diypinball/base-module-pcb/readme.txt

base-module-r1
==============
Size: Approx. 149mm x 99mm
Layers: 2
Silkscreen: White
Soldermask: Green
Thickness: 1.6mm
