diypinball/base-module-pcb/base-module-hardware-v2.kicad_pcb

## KiCad design base-module-hardware-v2.kicad_pcb (2016-09-09)

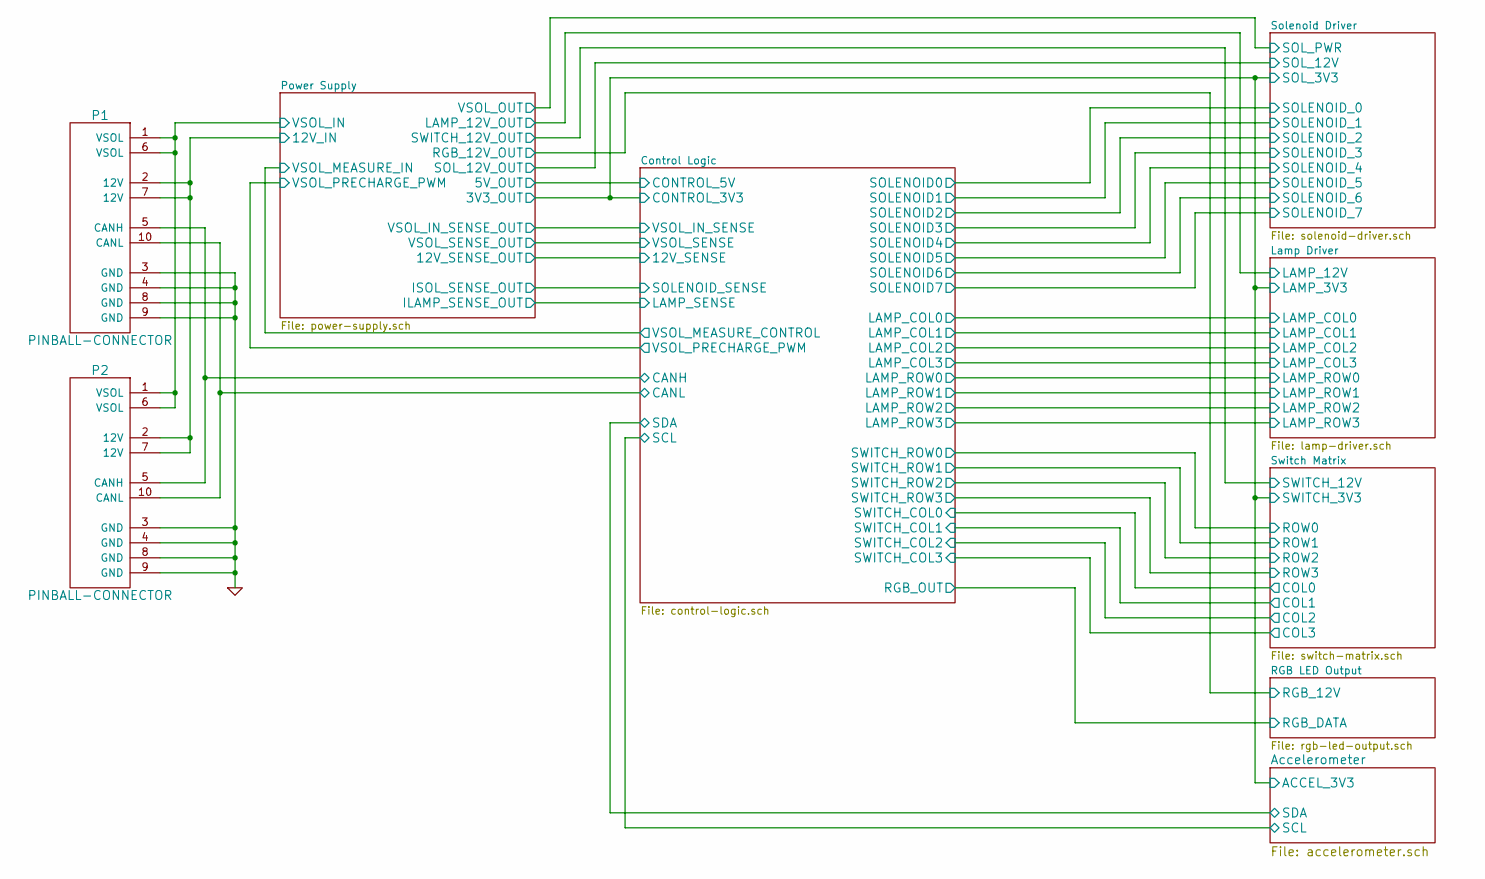
[picture p8: schematic base-module-hardware-v2.sch, DIYPinball Base Board]

Parts:
P1, P2: PINBALL-CONNECTOR; PINBALL-CONNECTOR-V

Connections:
/Control Logic/CANH: P1.5 (CANH), P2.5 (CANH); also elsewhere on the board
/Control Logic/CANL: P1.10 (CANL), P2.10 (CANL); also elsewhere on the board
/Power Supply/12V_IN: P1.2 (12V), P1.7 (12V), P2.2 (12V), P2.7 (12V); also elsewhere on the board
/Power Supply/VSOL_IN: P1.1 (VSOL), P1.6 (VSOL), P2.1 (VSOL), P2.6 (VSOL); also elsewhere on the board

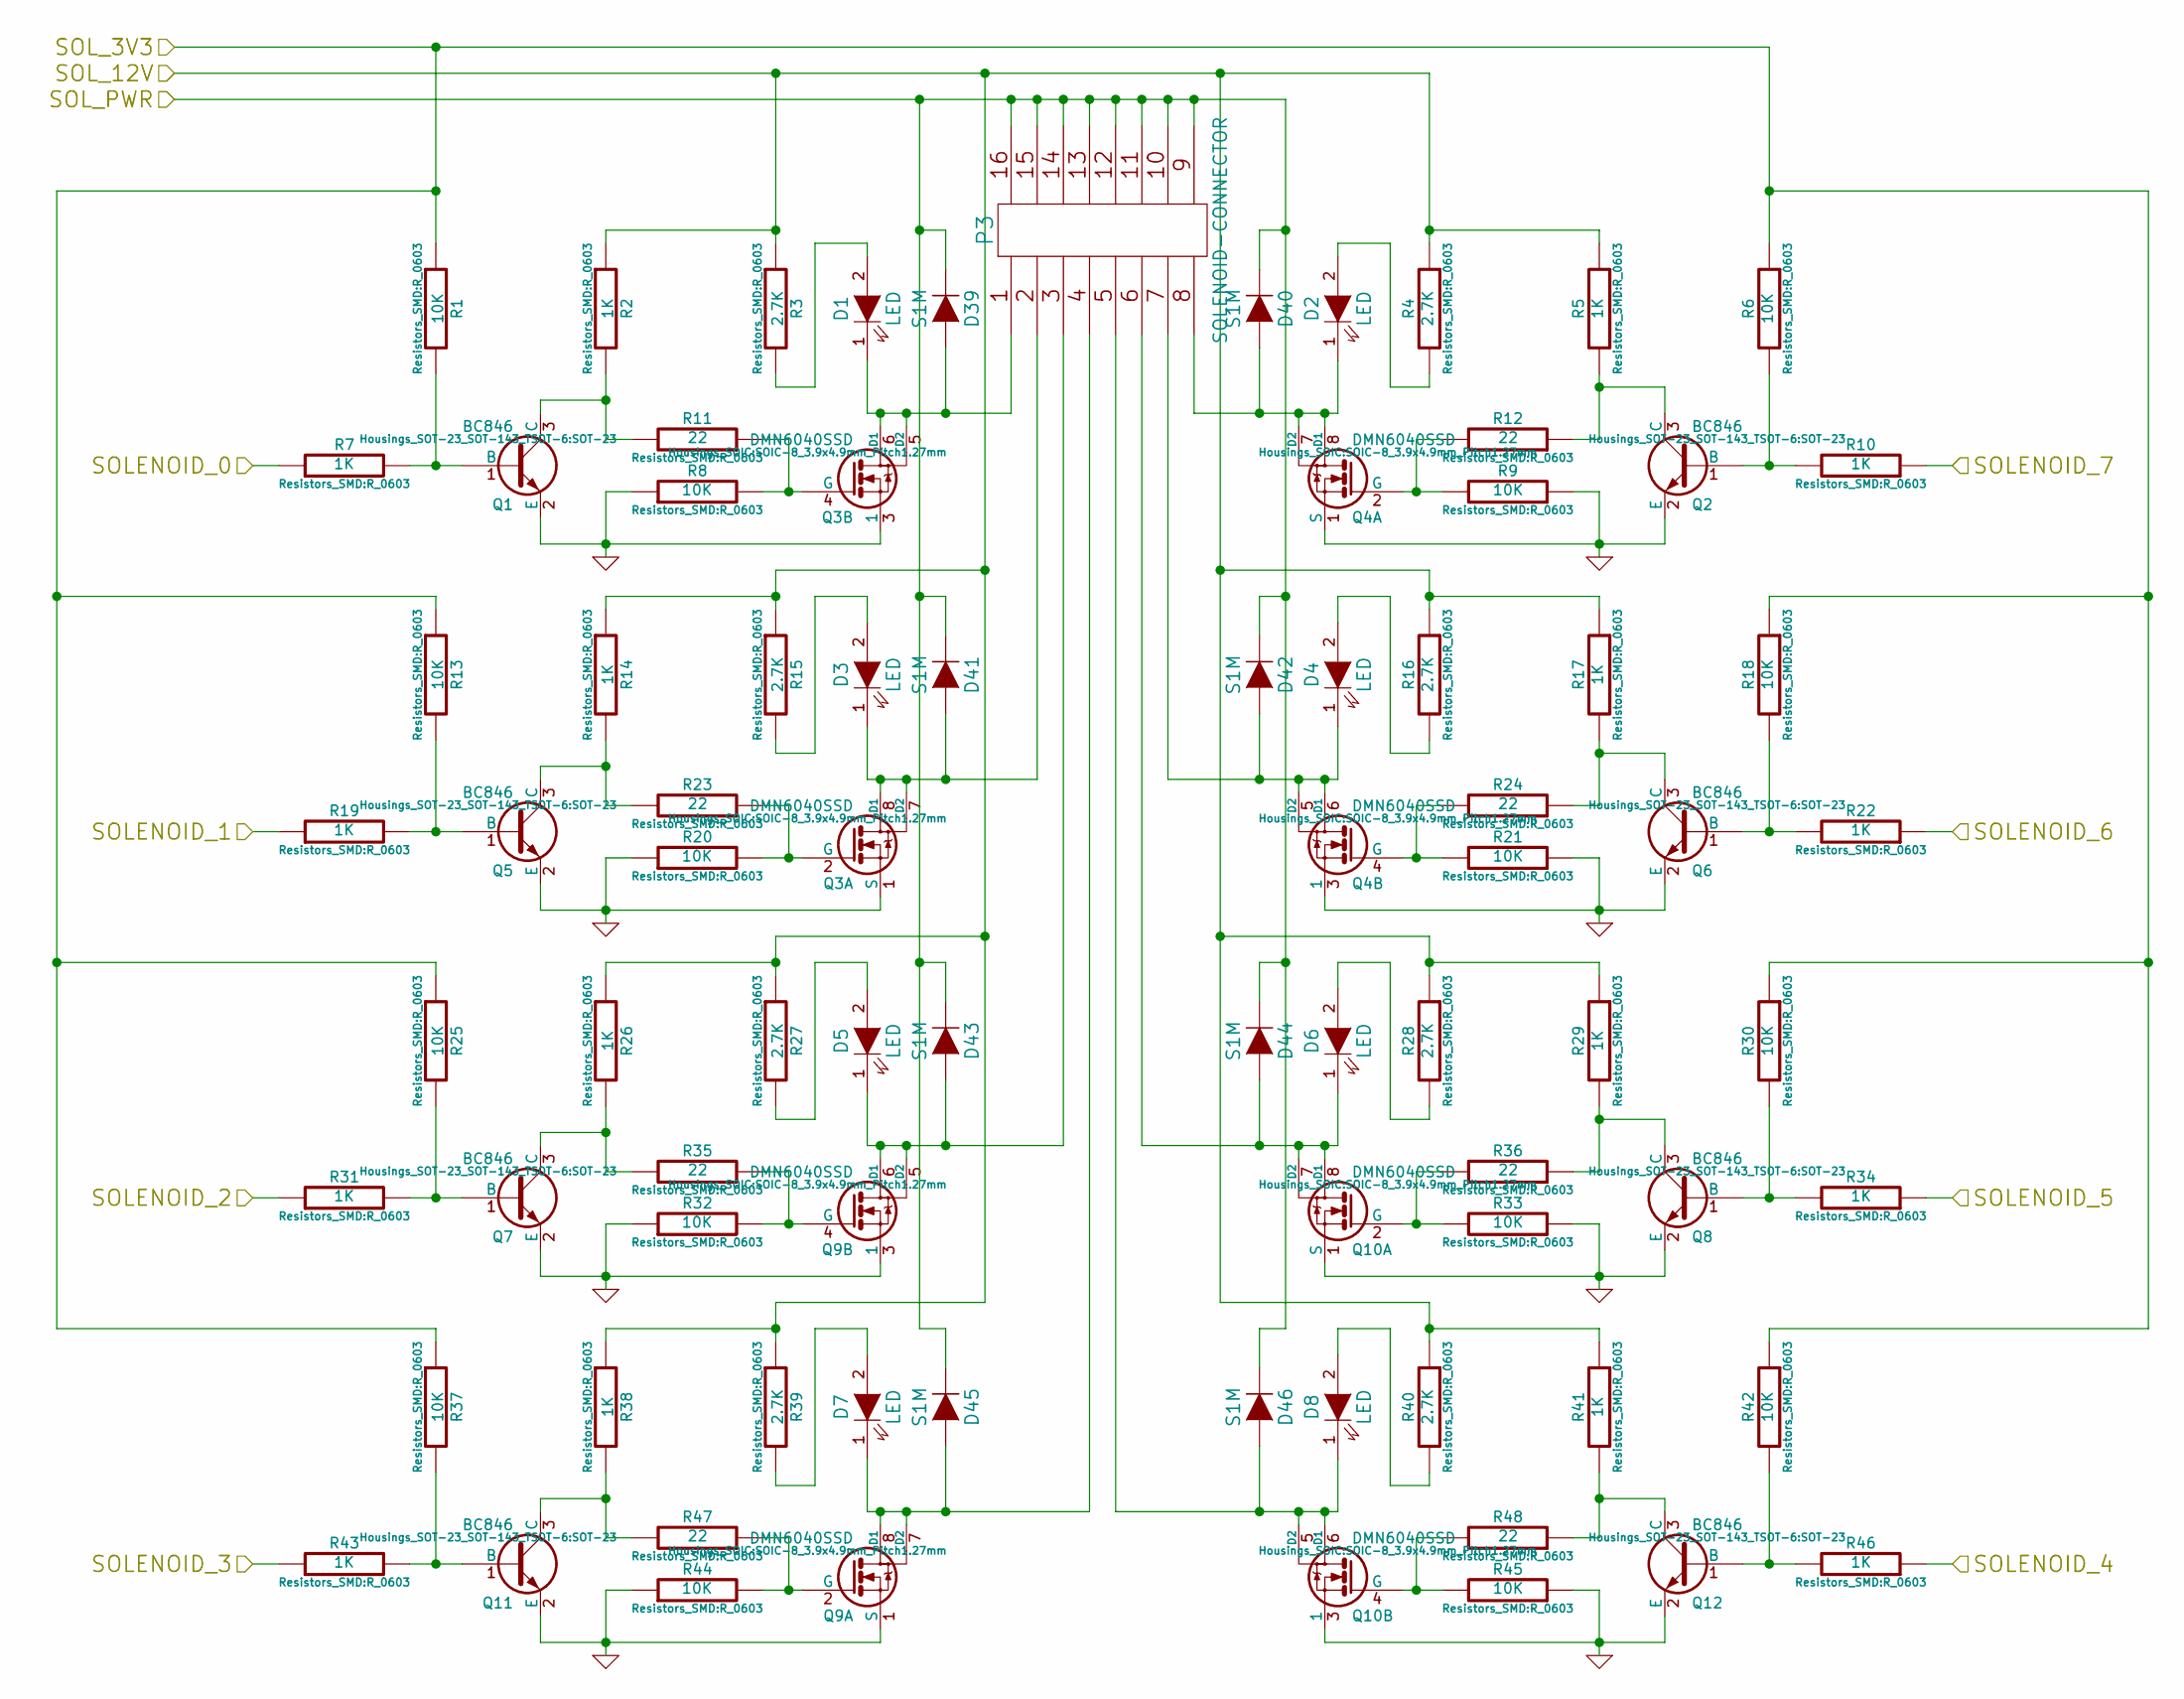
[picture p9: schematic solenoid-driver.sch, DIYPinball Base Board]

Parts:
D1, D2, D3, D4, D5, D6, D7, D8: LED; LED-0603
D39, D40, D41, D42, D43, D44, D45, D46: S1M; SMA_Standard
P3: SOLENOID-CONNECTOR; SOLENOID-CONNECTOR-V
Q1, Q2, Q5, Q6, Q7, Q8, Q11, Q12: BC846; SOT-23
Q3, Q4, Q9, Q10: DMN6040SSD; SOIC-8_3.9x4.9mm_Pitch1.27mm
R1, R6, R8, R9, R13, R18, R20, R21, R25, R30, R32, R33, R37, R42, R44, R45: 10K; R_0603
R2, R5, R7, R10, R14, R17, R19, R22, R26, R29, R31, R34, R38, R41, R43, R46: 1K; R_0603
R3, R4, R15, R16, R27, R28, R39, R40: 2.7K; R_0603
R11, R12, R23, R24, R35, R36, R47, R48: 22; R_0603

Connections:
+3.3V: R1.1, R6.1, R13.1, R18.1, R25.1, R30.1, R37.1, R42.1; also elsewhere on the board
+12V: R2.1, R3.1, R4.1, R5.1, R14.1, R15.1, R16.1, R17.1, R26.1, R27.1, R28.1, R29.1, R38.1, R39.1, R40.1, R41.1; also elsewhere on the board
/Control Logic/SOLENOID0: R7.1; also elsewhere on the board
/Control Logic/SOLENOID1: R19.1; also elsewhere on the board
/Control Logic/SOLENOID2: R31.1; also elsewhere on the board
/Control Logic/SOLENOID3: R43.1; also elsewhere on the board
/Control Logic/SOLENOID4: R46.1; also elsewhere on the board
/Control Logic/SOLENOID5: R34.1; also elsewhere on the board
/Control Logic/SOLENOID6: R22.1; also elsewhere on the board
/Control Logic/SOLENOID7: R10.1; also elsewhere on the board
/Solenoid Driver/SOL_PWR: D39.1 (K), D40.1 (K), D41.1 (K), D42.1 (K), D43.1 (K), D44.1 (K), D45.1 (K), D46.1 (K), P3.9, P3.10, P3.11, P3.12, P3.13, P3.14, P3.15, P3.16; also elsewhere on the board
unnamed: D1.1 (K), D39.2 (A), P3.1, Q3.5 (D2), Q3.6 (D1)
unnamed: D1.2 (A), R3.2
unnamed: D2.1 (K), D40.2 (A), P3.8, Q4.7 (D2), Q4.8 (D1)
unnamed: D2.2 (A), R4.2
unnamed: D3.1 (K), D41.2 (A), P3.2, Q3.7 (D2), Q3.8 (D1)
unnamed: D3.2 (A), R15.2
unnamed: D4.1 (K), D42.2 (A), P3.7, Q4.5 (D2), Q4.6 (D1)
unnamed: D4.2 (A), R16.2
unnamed: D5.2 (A), R27.2
unnamed: D6.2 (A), R28.2
unnamed: D7.2 (A), R39.2
unnamed: D8.2 (A), R40.2
unnamed: D5.1 (K), D43.2 (A), P3.3, Q9.5 (D2), Q9.6 (D1)
unnamed: D6.1 (K), D44.2 (A), P3.6, Q10.7 (D2), Q10.8 (D1)
unnamed: D7.1 (K), D45.2 (A), P3.4, Q9.7 (D2), Q9.8 (D1)
unnamed: D8.1 (K), D46.2 (A), P3.5, Q10.5 (D2), Q10.6 (D1)
unnamed: Q1.1 (B), R1.2, R7.2
unnamed: Q1.3 (C), R2.2, R11.2
unnamed: Q2.1 (B), R6.2, R10.2
unnamed: Q2.3 (C), R5.2, R12.1
unnamed: Q3.2 (G), R20.2, R23.1
unnamed: Q3.4 (G), R8.2, R11.1
unnamed: Q4.2 (G), R9.2, R12.2
unnamed: Q4.4 (G), R21.2, R24.2
unnamed: Q5.1 (B), R13.2, R19.2
unnamed: Q5.3 (C), R14.2, R23.2
unnamed: Q6.1 (B), R18.2, R22.2
unnamed: Q6.3 (C), R17.2, R24.1
unnamed: Q7.1 (B), R25.2, R31.2
unnamed: Q7.3 (C), R26.2, R35.2
unnamed: Q8.1 (B), R30.2, R34.2
unnamed: Q8.3 (C), R29.2, R36.1
unnamed: Q9.2 (G), R44.2, R47.1
unnamed: Q9.4 (G), R32.2, R35.1
unnamed: Q10.2 (G), R33.2, R36.2
unnamed: Q10.4 (G), R45.2, R48.2
unnamed: Q11.1 (B), R37.2, R43.2
unnamed: Q11.3 (C), R38.2, R47.2
unnamed: Q12.1 (B), R42.2, R46.2
unnamed: Q12.3 (C), R41.2, R48.1

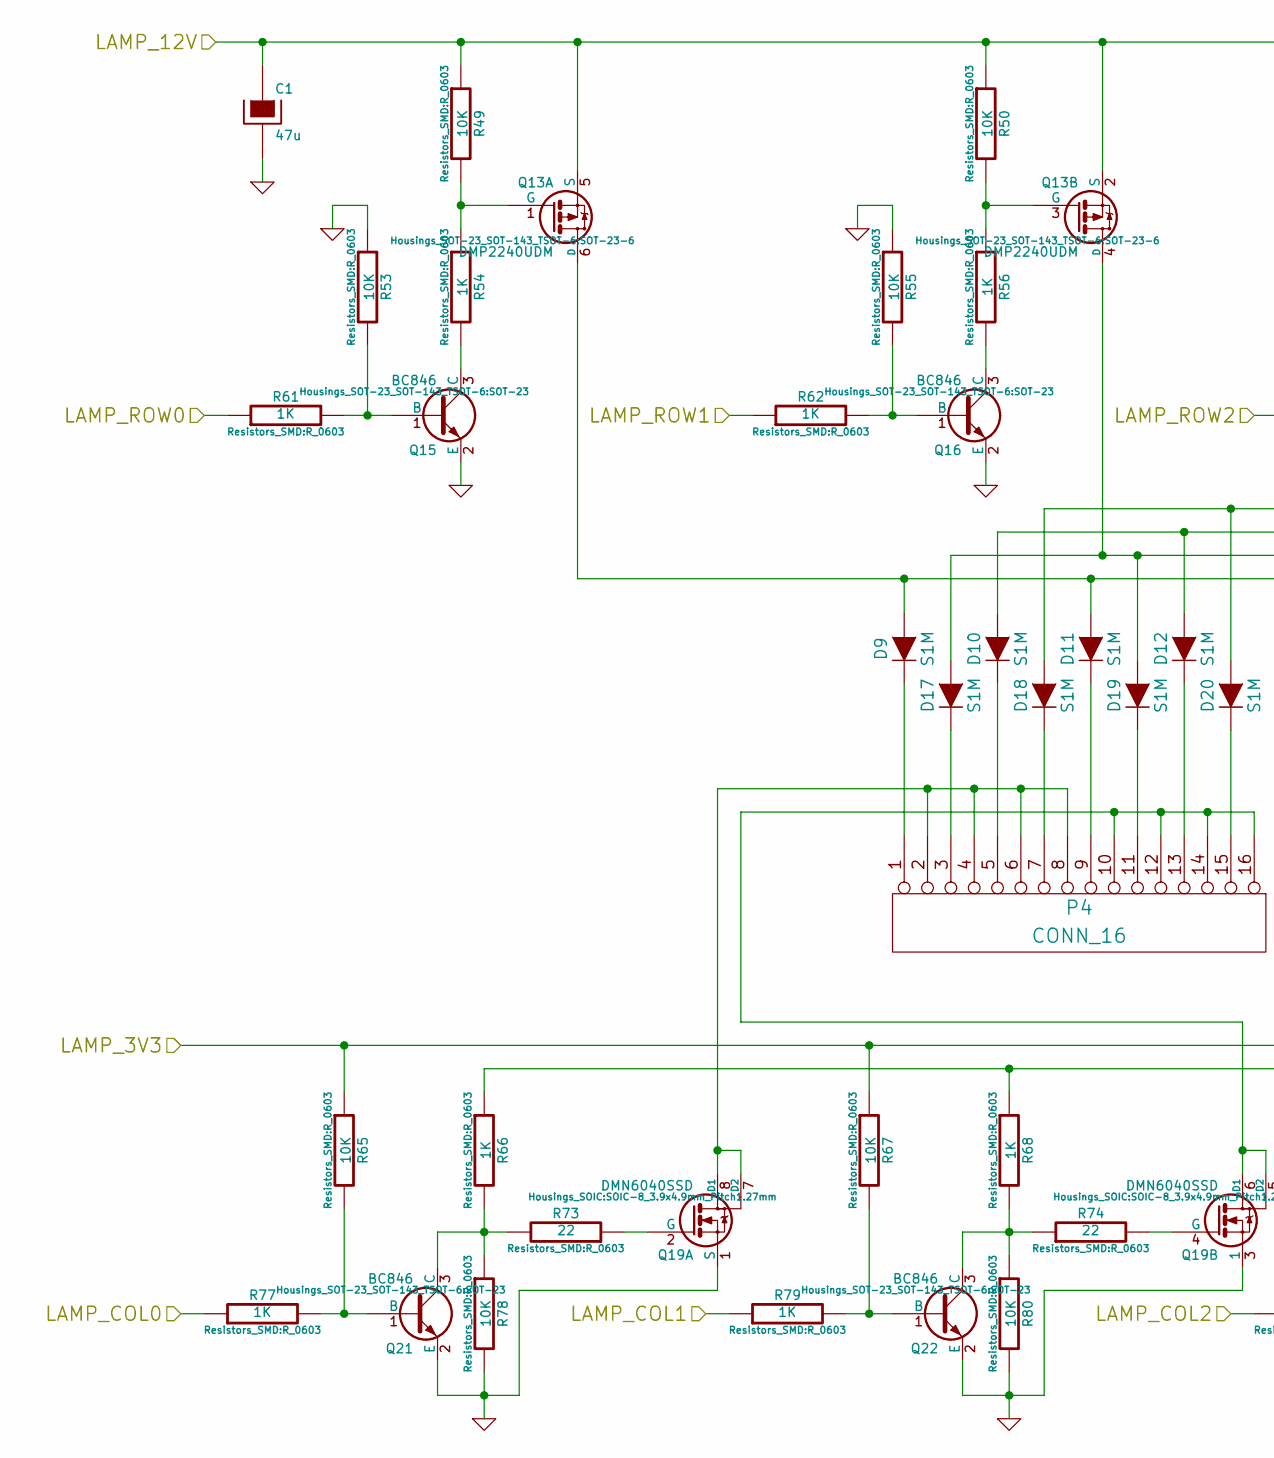
[picture p10: schematic lamp-driver.sch, DIYPinball Base Board, part in row 1, column 1]

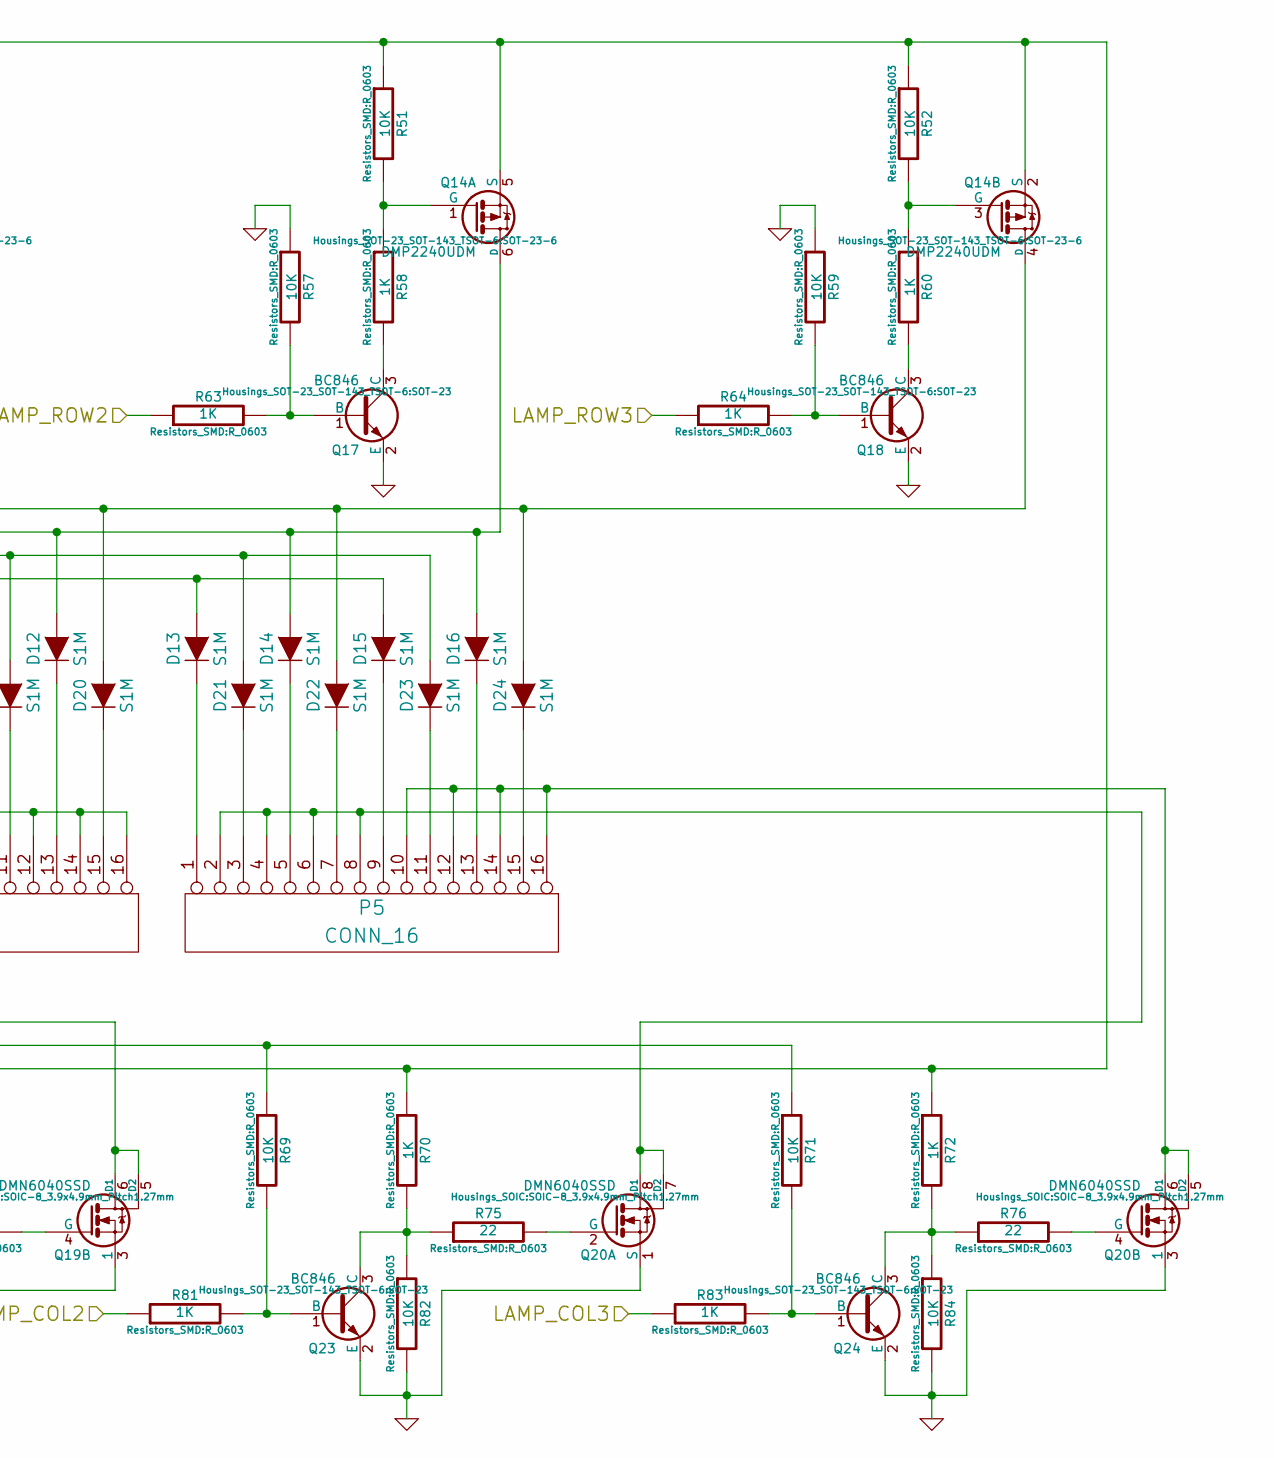
[picture p11: schematic lamp-driver.sch, DIYPinball Base Board, part in row 1, column 2]

Parts:
C1: 47u; c_elec_8x10
D9, D10, D11, D12, D13, D14, D15, D16, D17, D18, D19, D20, D21, D22, D23, D24: S1M; SMA_Standard
P4, P5: CONN_16; Socket_MOLEX-KK-RM2-54mm_Lock_16pin_straight
Q13, Q14: DMP2240UDM; SOT-23-6
Q15, Q16, Q17, Q18, Q21, Q22, Q23, Q24: BC846; SOT-23
Q19, Q20: DMN6040SSD; SOIC-8_3.9x4.9mm_Pitch1.27mm
R49, R50, R51, R52, R53, R55, R57, R59, R65, R67, R69, R71, R78, R80, R82, R84: 10K; R_0603
R54, R56, R58, R60, R61, R62, R63, R64, R66, R68, R70, R72, R77, R79, R81, R83: 1K; R_0603
R73, R74, R75, R76: 22; R_0603

Connections:
+3.3V: R65.1, R67.1, R69.1, R71.1; also elsewhere on the board
/Control Logic/LAMP_COL0: R77.1; also elsewhere on the board
/Control Logic/LAMP_COL1: R79.1; also elsewhere on the board
/Control Logic/LAMP_COL2: R81.1; also elsewhere on the board
/Control Logic/LAMP_COL3: R83.1; also elsewhere on the board
/Control Logic/LAMP_ROW0: R61.1; also elsewhere on the board
/Control Logic/LAMP_ROW1: R62.1; also elsewhere on the board
/Control Logic/LAMP_ROW2: R63.1; also elsewhere on the board
/Control Logic/LAMP_ROW3: R64.1; also elsewhere on the board
/Lamp Driver/LAMP_12V: C1.1, Q13.2 (S), Q13.5 (S), Q14.2 (S), Q14.5 (S), R49.1, R50.1, R51.1, R52.1, R66.1, R68.1, R70.1, R72.1; also elsewhere on the board
unnamed: D9.1 (K), P4.1
unnamed: D10.1 (K), P4.5
unnamed: D10.2 (A), D12.2 (A), D14.2 (A), D16.2 (A), Q14.6 (D)
unnamed: D11.1 (K), P4.9
unnamed: D9.2 (A), D11.2 (A), D13.2 (A), D15.2 (A), Q13.6 (D)
unnamed: D12.1 (K), P4.13
unnamed: D13.1 (K), P5.1
unnamed: D14.1 (K), P5.5
unnamed: D15.1 (K), P5.9
unnamed: D16.1 (K), P5.13
unnamed: D17.1 (K), P4.3
unnamed: D17.2 (A), D19.2 (A), D21.2 (A), D23.2 (A), Q13.4 (D)
unnamed: D18.1 (K), P4.7
unnamed: D18.2 (A), D20.2 (A), D22.2 (A), D24.2 (A), Q14.4 (D)
unnamed: D19.1 (K), P4.11
unnamed: D20.1 (K), P4.15
unnamed: D21.1 (K), P5.3
unnamed: D22.1 (K), P5.7
unnamed: D23.1 (K), P5.11
unnamed: D24.1 (K), P5.15
unnamed: P4.2, P4.4, P4.6, P4.8, Q19.7 (D2), Q19.8 (D1)
unnamed: P4.10, P4.12, P4.14, P4.16, Q19.5 (D2), Q19.6 (D1)
unnamed: P5.2, P5.4, P5.6, P5.8, Q20.7 (D2), Q20.8 (D1)
unnamed: P5.10, P5.12, P5.14, P5.16, Q20.5 (D2), Q20.6 (D1)
unnamed: Q13.1 (G), R49.2, R54.1
unnamed: Q13.3 (G), R50.2, R56.1
unnamed: Q14.1 (G), R51.2, R58.1
unnamed: Q14.3 (G), R52.2, R60.1
unnamed: Q15.1 (B), R53.2, R61.2
unnamed: Q15.3 (C), R54.2
unnamed: Q16.1 (B), R55.2, R62.2
unnamed: Q16.3 (C), R56.2
unnamed: Q17.1 (B), R57.2, R63.2
unnamed: Q17.3 (C), R58.2
unnamed: Q18.1 (B), R59.2, R64.2
unnamed: Q18.3 (C), R60.2
unnamed: Q19.2 (G), R73.1
unnamed: Q19.4 (G), R74.2
unnamed: Q20.2 (G), R75.2
unnamed: Q20.4 (G), R76.2
unnamed: Q21.1 (B), R65.2, R77.2
unnamed: Q21.3 (C), R66.2, R73.2, R78.1
unnamed: Q22.1 (B), R67.2, R79.2
unnamed: Q22.3 (C), R68.2, R74.1, R80.1
unnamed: Q23.1 (B), R69.2, R81.2
unnamed: Q23.3 (C), R70.2, R75.1, R82.1
unnamed: Q24.1 (B), R71.2, R83.2
unnamed: Q24.3 (C), R72.2, R76.1, R84.1

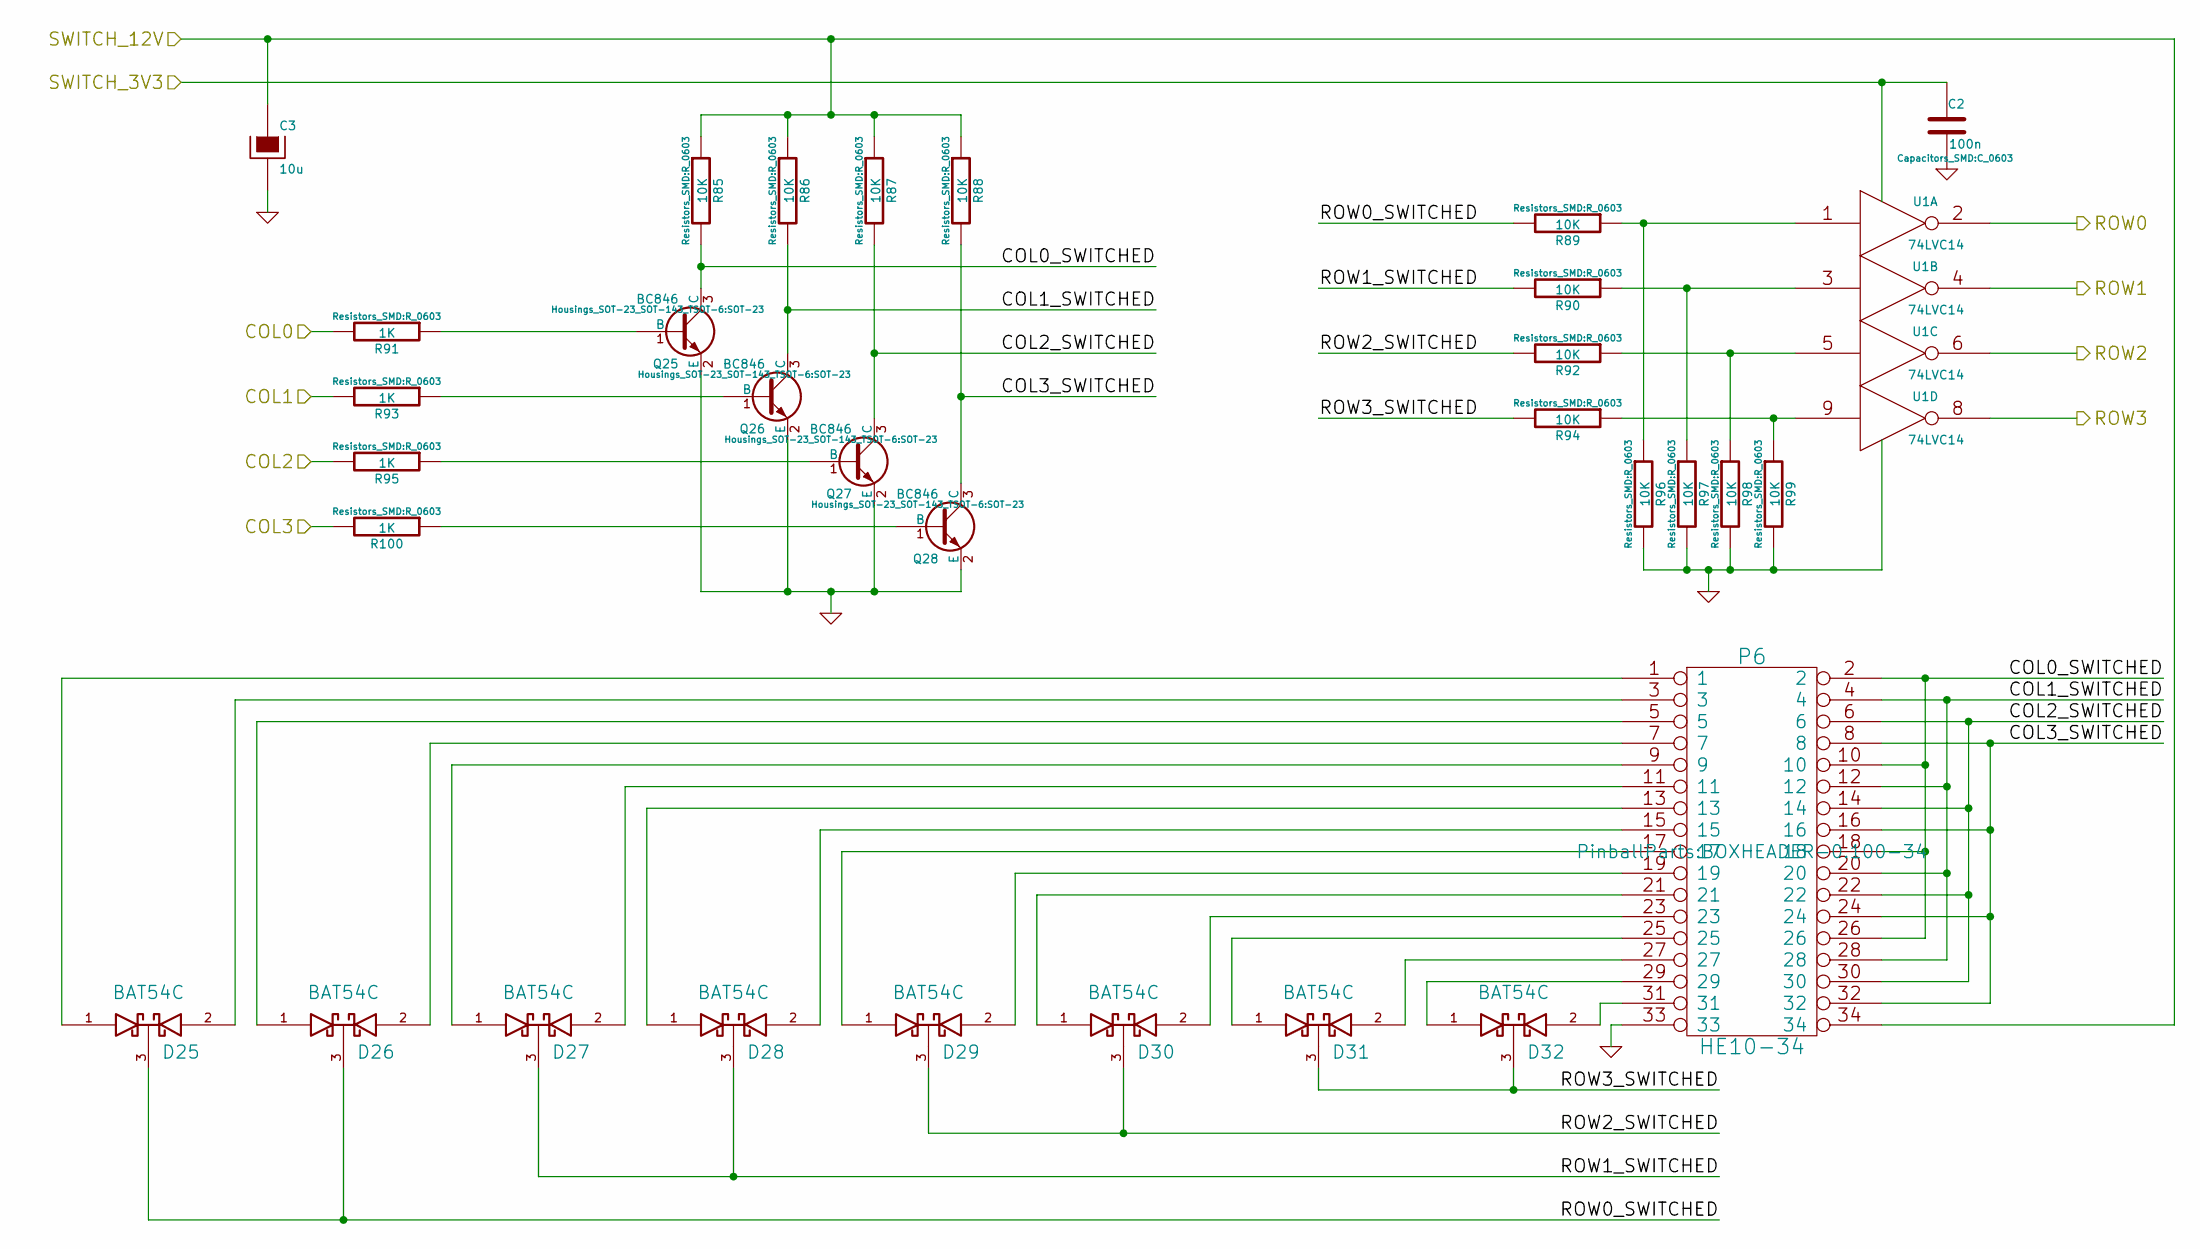
[picture p12: schematic switch-matrix.sch, DIYPinball Base Board]

Parts:
C2: 100n; C_0603
C3: 10u; C_0805
D25, D26, D27, D28, D29, D30, D31, D32: BAT54C; SOT-23
P6: HE10-34; BOXHEADER-0.100-34
Q25, Q26, Q27, Q28: BC846; SOT-23
R85, R86, R87, R88, R89, R90, R92, R94, R96, R97, R98, R99: 10K; R_0603
R91, R93, R95, R100: 1K; R_0603
U1: 74LVC14; SSOP-14_5.3x6.2mm_Pitch0.65mm

Connections:
+3.3V: C2.1, U1.14 (VCC); also elsewhere on the board
+12V: C3.1, P6.34, R85.1, R86.1, R87.1, R88.1; also elsewhere on the board
/Switch Matrix/COL0: R91.2; also elsewhere on the board
/Switch Matrix/COL0_SWITCHED: P6.2, P6.10, P6.18, P6.26, Q25.3 (C), R85.2
/Switch Matrix/COL1: R93.2; also elsewhere on the board
/Switch Matrix/COL1_SWITCHED: P6.4, P6.12, P6.20, P6.28, Q26.3 (C), R86.2
/Switch Matrix/COL2: R95.2; also elsewhere on the board
/Switch Matrix/COL2_SWITCHED: P6.6, P6.14, P6.22, P6.30, Q27.3 (C), R87.2
/Switch Matrix/COL3: R100.2; also elsewhere on the board
/Switch Matrix/COL3_SWITCHED: P6.8, P6.16, P6.24, P6.32, Q28.3 (C), R88.2
/Switch Matrix/ROW0: U1.2; also elsewhere on the board
/Switch Matrix/ROW0_SWITCHED: D25.3 (AK), D26.3 (AK), R89.2
/Switch Matrix/ROW1: U1.4; also elsewhere on the board
/Switch Matrix/ROW1_SWITCHED: D27.3 (AK), D28.3 (AK), R90.2
/Switch Matrix/ROW2: U1.6; also elsewhere on the board
/Switch Matrix/ROW2_SWITCHED: D29.3 (AK), D30.3 (AK), R92.2
/Switch Matrix/ROW3: U1.8; also elsewhere on the board
/Switch Matrix/ROW3_SWITCHED: D31.3 (AK), D32.3 (AK), R94.2
unnamed: D25.1 (Anode), P6.1
unnamed: D25.2 (cathode), P6.3
unnamed: D26.1 (Anode), P6.5
unnamed: D26.2 (cathode), P6.7
unnamed: D27.1 (Anode), P6.9
unnamed: D27.2 (cathode), P6.11
unnamed: D28.1 (Anode), P6.13
unnamed: D28.2 (cathode), P6.15
unnamed: D29.1 (Anode), P6.17
unnamed: D29.2 (cathode), P6.19
unnamed: D30.1 (Anode), P6.21
unnamed: D30.2 (cathode), P6.23
unnamed: D31.1 (Anode), P6.25
unnamed: D31.2 (cathode), P6.27
unnamed: D32.1 (Anode), P6.29
unnamed: D32.2 (cathode), P6.31
unnamed: Q25.1 (B), R91.1
unnamed: Q26.1 (B), R93.1
unnamed: Q27.1 (B), R95.1
unnamed: Q28.1 (B), R100.1
unnamed: R89.1, R96.1, U1.1
unnamed: R90.1, R97.1, U1.3
unnamed: R92.1, R98.1, U1.5
unnamed: R94.1, R99.1, U1.9

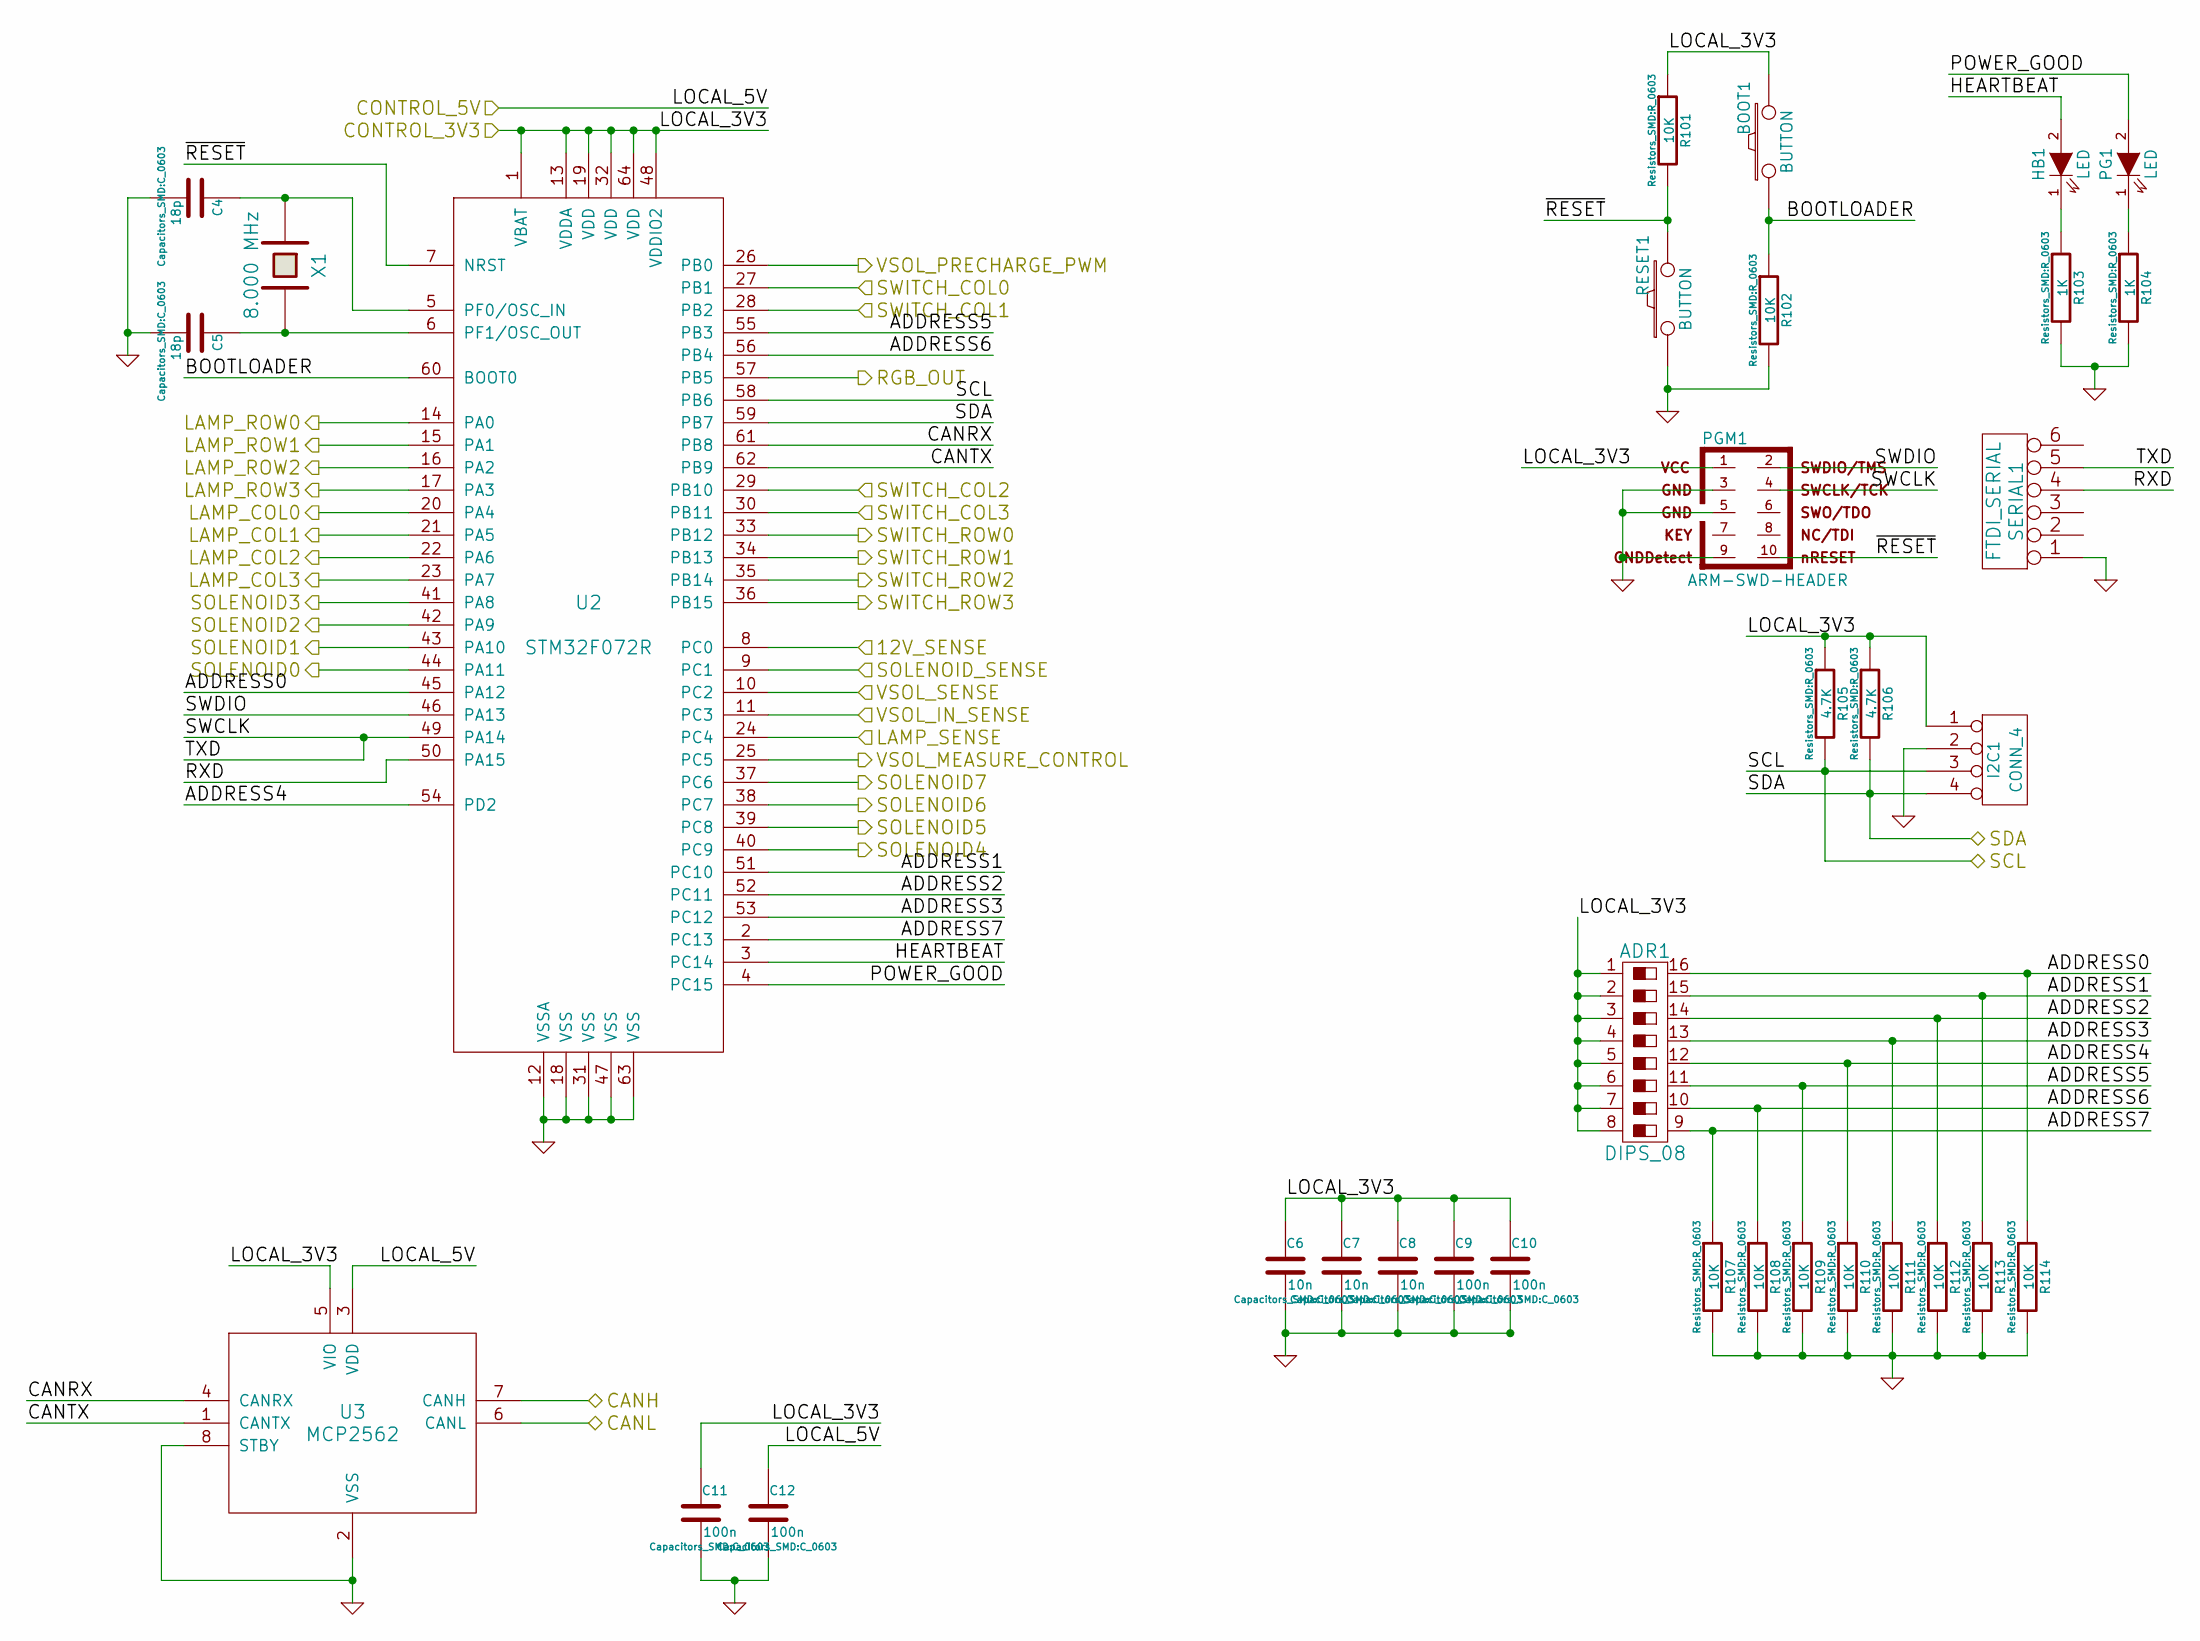
[picture p13: schematic control-logic.sch, DIYPinball Base Board]

Parts:
ADR1: DIPS_08; DIPSWITCH-SMT-08
BOOT1: BUTTON; SW_PUSH_SMALL
C4, C5: 18p; C_0603
C6, C7, C8: 10n; C_0603
C9, C10, C11, C12: 100n; C_0603
HB1: LED; LED-0603
I2C1: CONN_4; Socket_MOLEX-KK-RM2-54mm_Lock_4pin_straight
PG1: LED; LED-0603
PGM1: ARM-SWD-HEADER; pin_array_5x2_50mil_smd
R101, R102, R107, R108, R109, R110, R111, R112, R113, R114: 10K; R_0603
R103, R104: 1K; R_0603
R105, R106: 4.7K; R_0603
RESET1: BUTTON; SW_PUSH_SMALL
SERIAL1: FTDI_SERIAL; Socket_Strip_Straight_1x06
U2: STM32F072R; LQFP-64_10x10mm_Pitch0.5mm
U3: MCP2562; SOIC-8_3.9x4.9mm_Pitch1.27mm
X1: 8.000 MHz; Q_49U3HMS

Connections:
+3.3V: ADR1.1, ADR1.2, ADR1.3, ADR1.4, ADR1.5, ADR1.6, ADR1.7, ADR1.8, BOOT1.2, C6.1, C7.1, C8.1, C9.1, C10.1, C11.1, I2C1.1, PGM1.1, R101.1, R105.1, R106.1, U2.1 (VBAT), U2.13 (VDDA), U2.19 (VDD), U2.32 (VDD), U2.48 (VDDIO2), U2.64 (VDD), U3.5 (VIO); also elsewhere on the board
+5V: C12.1, U3.3 (VDD); also elsewhere on the board
/Accelerometer/SCL: I2C1.3, R105.2, U2.58 (PB6); also elsewhere on the board
/Accelerometer/SDA: I2C1.4, R106.2, U2.59 (PB7); also elsewhere on the board
/Control Logic/12V_SENSE: U2.8 (PC0); also elsewhere on the board
/Control Logic/ADDRESS0: ADR1.16, R114.1, U2.45 (PA12)
/Control Logic/ADDRESS1: ADR1.15, R113.1, U2.51 (PC10)
/Control Logic/ADDRESS2: ADR1.14, R112.1, U2.52 (PC11)
/Control Logic/ADDRESS3: ADR1.13, R111.1, U2.53 (PC12)
/Control Logic/ADDRESS4: ADR1.12, R110.1, U2.54 (PD2)
/Control Logic/ADDRESS5: ADR1.11, R109.1, U2.55 (PB3)
/Control Logic/ADDRESS6: ADR1.10, R108.1, U2.56 (PB4)
/Control Logic/ADDRESS7: ADR1.9, R107.1, U2.2 (PC13)
/Control Logic/BOOTLOADER: BOOT1.1, R102.1, U2.60 (BOOT0)
/Control Logic/CANH: U3.7 (CANH); also elsewhere on the board
/Control Logic/CANL: U3.6 (CANL); also elsewhere on the board
/Control Logic/CANRX: U2.61 (PB8), U3.4 (CANRX)
/Control Logic/CANTX: U2.62 (PB9), U3.1 (CANTX)
/Control Logic/HEARTBEAT: HB1.2 (A), U2.3 (PC14)
/Control Logic/LAMP_COL0: U2.20 (PA4); also elsewhere on the board
/Control Logic/LAMP_COL1: U2.21 (PA5); also elsewhere on the board
/Control Logic/LAMP_COL2: U2.22 (PA6); also elsewhere on the board
/Control Logic/LAMP_COL3: U2.23 (PA7); also elsewhere on the board
/Control Logic/LAMP_ROW0: U2.14 (PA0); also elsewhere on the board
/Control Logic/LAMP_ROW1: U2.15 (PA1); also elsewhere on the board
/Control Logic/LAMP_ROW2: U2.16 (PA2); also elsewhere on the board
/Control Logic/LAMP_ROW3: U2.17 (PA3); also elsewhere on the board
/Control Logic/POWER_GOOD: PG1.2 (A), U2.4 (PC15)
/Control Logic/RXD: SERIAL1.4, U2.50 (PA15)
/Control Logic/SOLENOID0: U2.44 (PA11); also elsewhere on the board
/Control Logic/SOLENOID1: U2.43 (PA10); also elsewhere on the board
/Control Logic/SOLENOID2: U2.42 (PA9); also elsewhere on the board
/Control Logic/SOLENOID3: U2.41 (PA8); also elsewhere on the board
/Control Logic/SOLENOID4: U2.40 (PC9); also elsewhere on the board
/Control Logic/SOLENOID5: U2.39 (PC8); also elsewhere on the board
/Control Logic/SOLENOID6: U2.38 (PC7); also elsewhere on the board
/Control Logic/SOLENOID7: U2.37 (PC6); also elsewhere on the board
/Control Logic/SWCLK: PGM1.4, SERIAL1.5, U2.49 (PA14)
/Control Logic/SWDIO: PGM1.2, U2.46 (PA13)
/Control Logic/VSOL_PRECHARGE_PWM: U2.26 (PB0); also elsewhere on the board
/Control Logic/VSOL_SENSE: U2.10 (PC2); also elsewhere on the board
/Control Logic/~RESET: PGM1.10, R101.2, RESET1.2, U2.7 (NRST)
/Power Supply/ILAMP_SENSE_OUT: U2.24 (PC4); also elsewhere on the board
/Power Supply/ISOL_SENSE_OUT: U2.9 (PC1); also elsewhere on the board
/RGB LED Output/RGB_DATA: U2.57 (PB5); also elsewhere on the board
/Switch Matrix/COL0: U2.27 (PB1); also elsewhere on the board
/Switch Matrix/COL1: U2.28 (PB2); also elsewhere on the board
/Switch Matrix/COL2: U2.29 (PB10); also elsewhere on the board
/Switch Matrix/COL3: U2.30 (PB11); also elsewhere on the board
/Switch Matrix/ROW0: U2.33 (PB12); also elsewhere on the board
/Switch Matrix/ROW1: U2.34 (PB13); also elsewhere on the board
/Switch Matrix/ROW2: U2.35 (PB14); also elsewhere on the board
/Switch Matrix/ROW3: U2.36 (PB15); also elsewhere on the board
unnamed: C4.1, U2.5 (PF0/OSC_IN), X1.1
unnamed: C5.1, U2.6 (PF1/OSC_OUT), X1.2
unnamed: HB1.1 (K), R103.1
unnamed: PG1.1 (K), R104.1
