diypinball/base-module-pcb/base-module-hardware-v2.kicad_pcb

## KiCad design base-module-hardware-v2.kicad_pcb (continued)

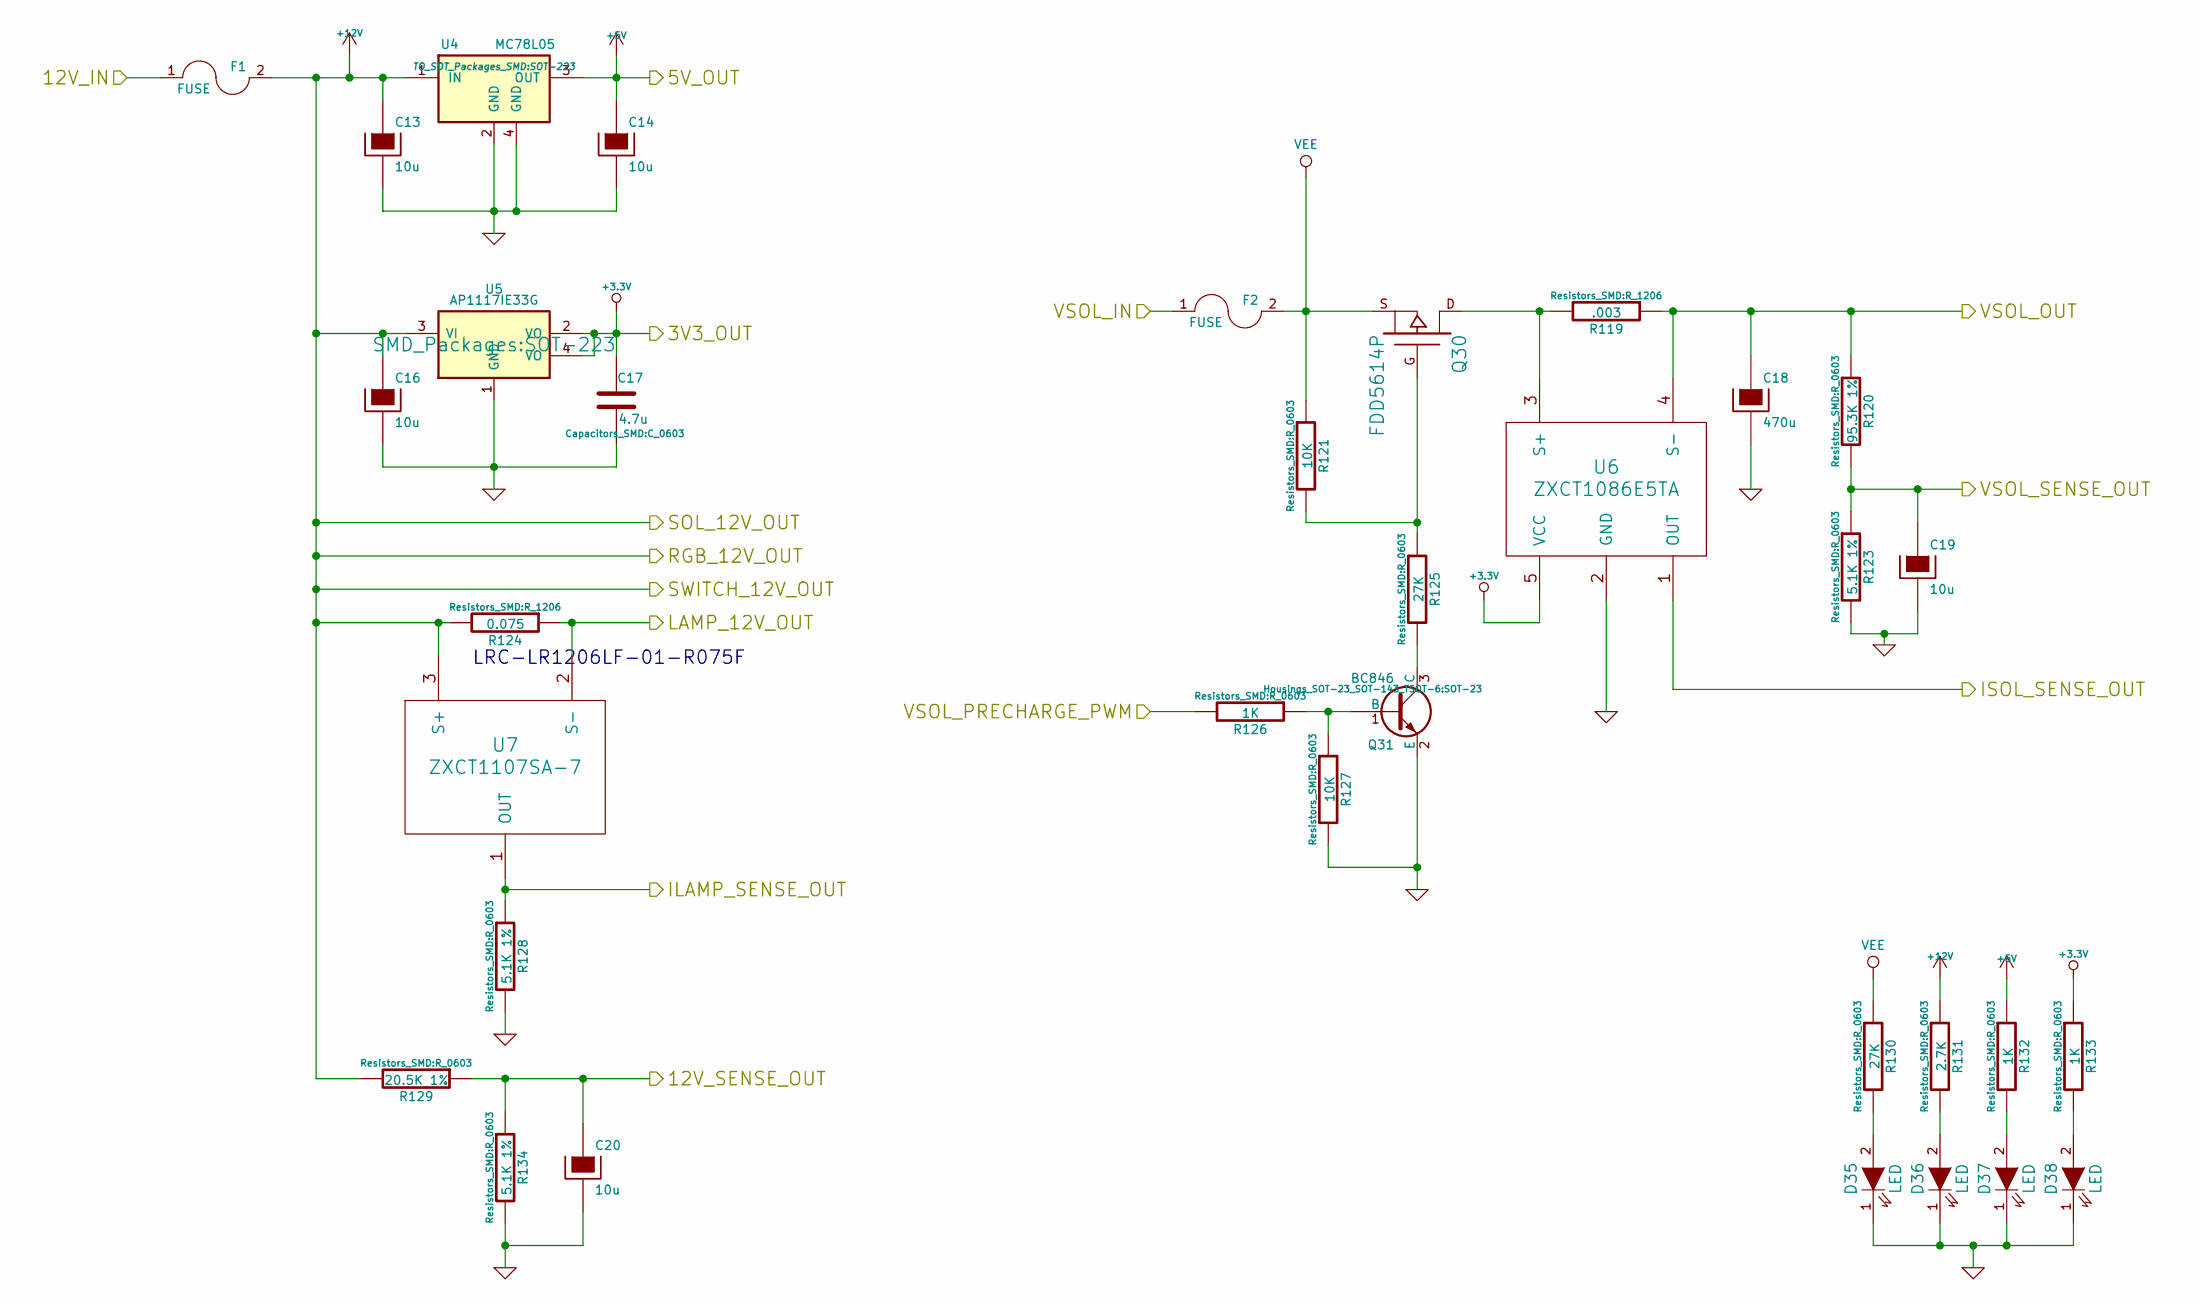
[picture p14: schematic power-supply.sch, DIYPinball Base Board]

Parts:
C13, C14, C16, C19, C20: 10u; C_0805
C17: 4.7u; C_0603
C18: 470u; C_Radial_D16_L25_P7.5
D35, D36, D37, D38: LED; LED-0603
F1, F2: FUSE; FC203-20MM
Q30: FDD5614P; DPAK-2
Q31: BC846; SOT-23
R119: .003; R_1206; Digikey P/N 989-1026-1-ND
R120: 95.3K 1%; R_0603
R121, R127: 10K; R_0603
R123, R128, R134: 5.1K 1%; R_0603
R124: 0.075; R_1206; Digikey P/N 989-1030-1-ND
R125, R130: 27K; R_0603
R126, R132, R133: 1K; R_0603
R129: 20.5K 1%; R_0603
R131: 2.7K; R_0603
U4: MC78L05; SOT-223
U5: AP1117IE33G; SOT-223
U6: ZXCT1086E5TA; SOT-23-5
U7: ZXCT1107SA-7; SOT-23

Connections:
+3.3V: C17.1, R133.1, U5.2 (VO), U5.4 (VO), U6.5 (VCC); also elsewhere on the board
+5V: C14.1, R132.1, U4.3 (OUT); also elsewhere on the board
+12V: C13.1, C16.1, F1.2, R124.2, R129.2, R131.1, U4.1 (IN), U5.3 (VI), U7.3 (S+); also elsewhere on the board
/Control Logic/12V_SENSE: C20.1, R129.1, R134.1; also elsewhere on the board
/Control Logic/VSOL_PRECHARGE_PWM: R126.2; also elsewhere on the board
/Control Logic/VSOL_SENSE: C19.1, R120.2, R123.1; also elsewhere on the board
/Lamp Driver/LAMP_12V: R124.1, U7.2 (S-); also elsewhere on the board
/Power Supply/12V_IN: F1.1; also elsewhere on the board
/Power Supply/ILAMP_SENSE_OUT: R128.1, U7.1 (OUT); also elsewhere on the board
/Power Supply/ISOL_SENSE_OUT: U6.1 (OUT); also elsewhere on the board
/Power Supply/VSOL_IN: F2.1; also elsewhere on the board
/Solenoid Driver/SOL_PWR: C18.1, R119.1, R120.1, U6.4 (S-); also elsewhere on the board
unnamed: D35.2 (A), R130.2
unnamed: D36.2 (A), R131.2
unnamed: D37.2 (A), R132.2
unnamed: D38.2 (A), R133.2
unnamed: Q30.D, R119.2, U6.3 (S+)
unnamed: Q30.G, R121.2, R125.1
unnamed: Q31.1 (B), R126.1, R127.1
unnamed: Q31.3 (C), R125.2
VEE: F2.2, Q30.S, R121.1, R130.1

Notes on the sheet:
LRC-LR1206LF-01-R075F

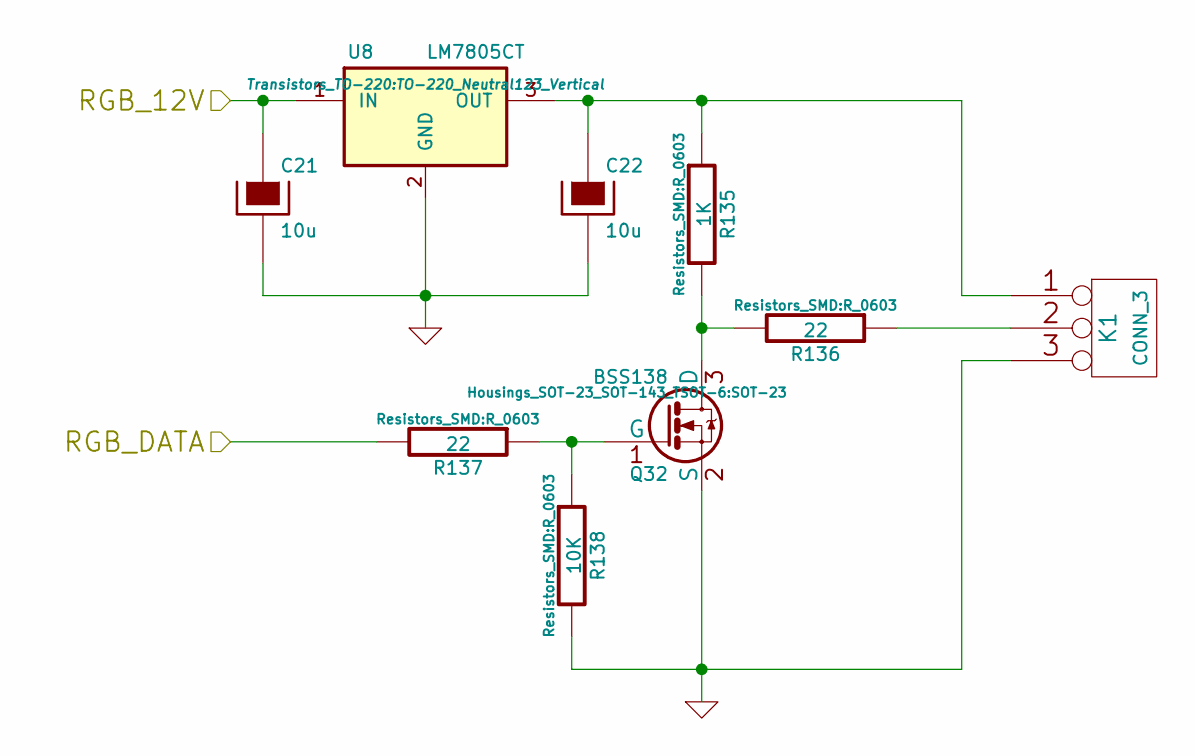
[picture p15: schematic rgb-led-output.sch, DIYPinball Base Board]

Parts:
C21, C22: 10u; C_0805
K1: CONN_3; Socket_MOLEX-KK-RM2-54mm_Lock_3pin_straight
Q32: BSS138; SOT-23
R135: 1K; R_0603
R136, R137: 22; R_0603
R138: 10K; R_0603
U8: LM7805CT; TO-220_Neutral123_Vertical

Connections:
+12V: C21.1, U8.1 (IN); also elsewhere on the board
/RGB LED Output/RGB_DATA: R137.2; also elsewhere on the board
unnamed: C22.1, K1.1, R135.1, U8.3 (OUT)
unnamed: K1.2 (PM), R136.1
unnamed: Q32.1 (G), R137.1, R138.1
unnamed: Q32.3 (D), R135.2, R136.2

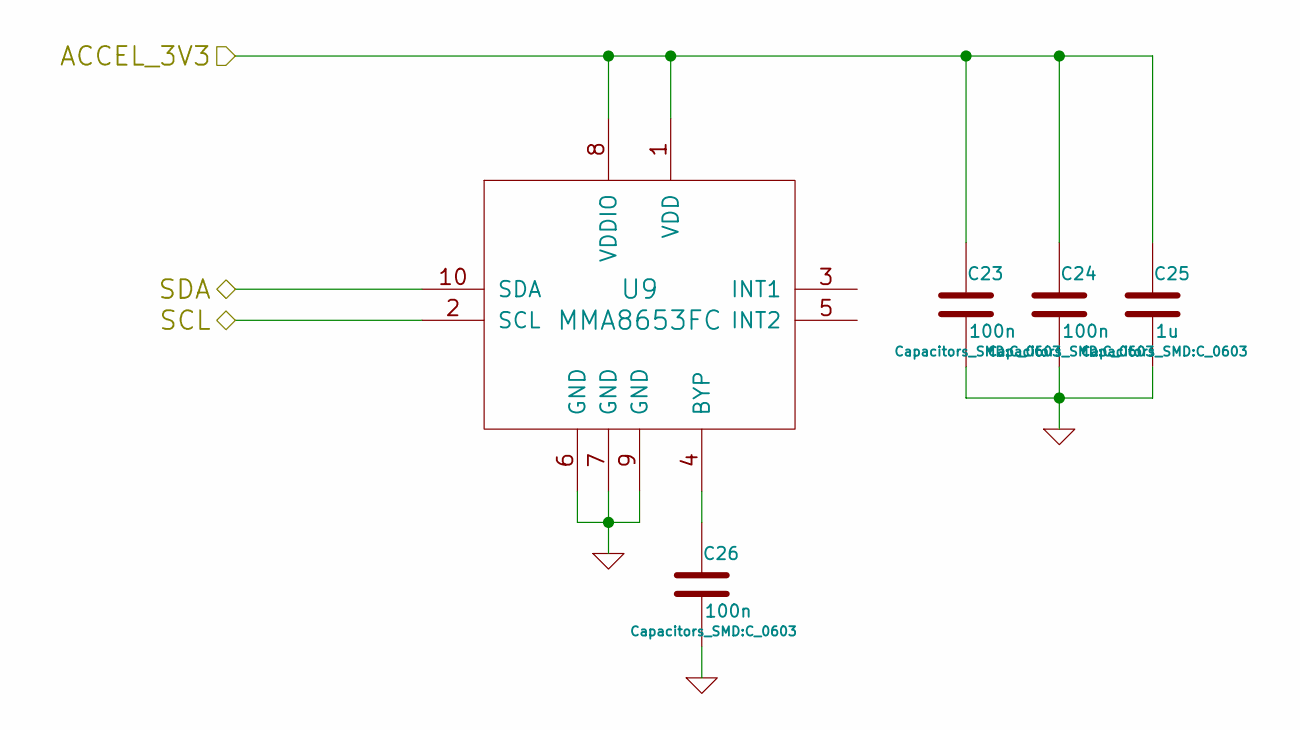
[picture p16: schematic accelerometer.sch]

Parts:
C23, C24, C26: 100n; C_0603
C25: 1u; C_0603
U9: MMA8653FC; DFN-10

Connections:
+3.3V: C23.1, C24.1, C25.1, U9.1 (VDD), U9.8 (VDDIO); also elsewhere on the board
/Accelerometer/SCL: U9.2 (SCL); also elsewhere on the board
/Accelerometer/SDA: U9.10 (SDA); also elsewhere on the board
unnamed: C26.1, U9.4 (BYP)

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
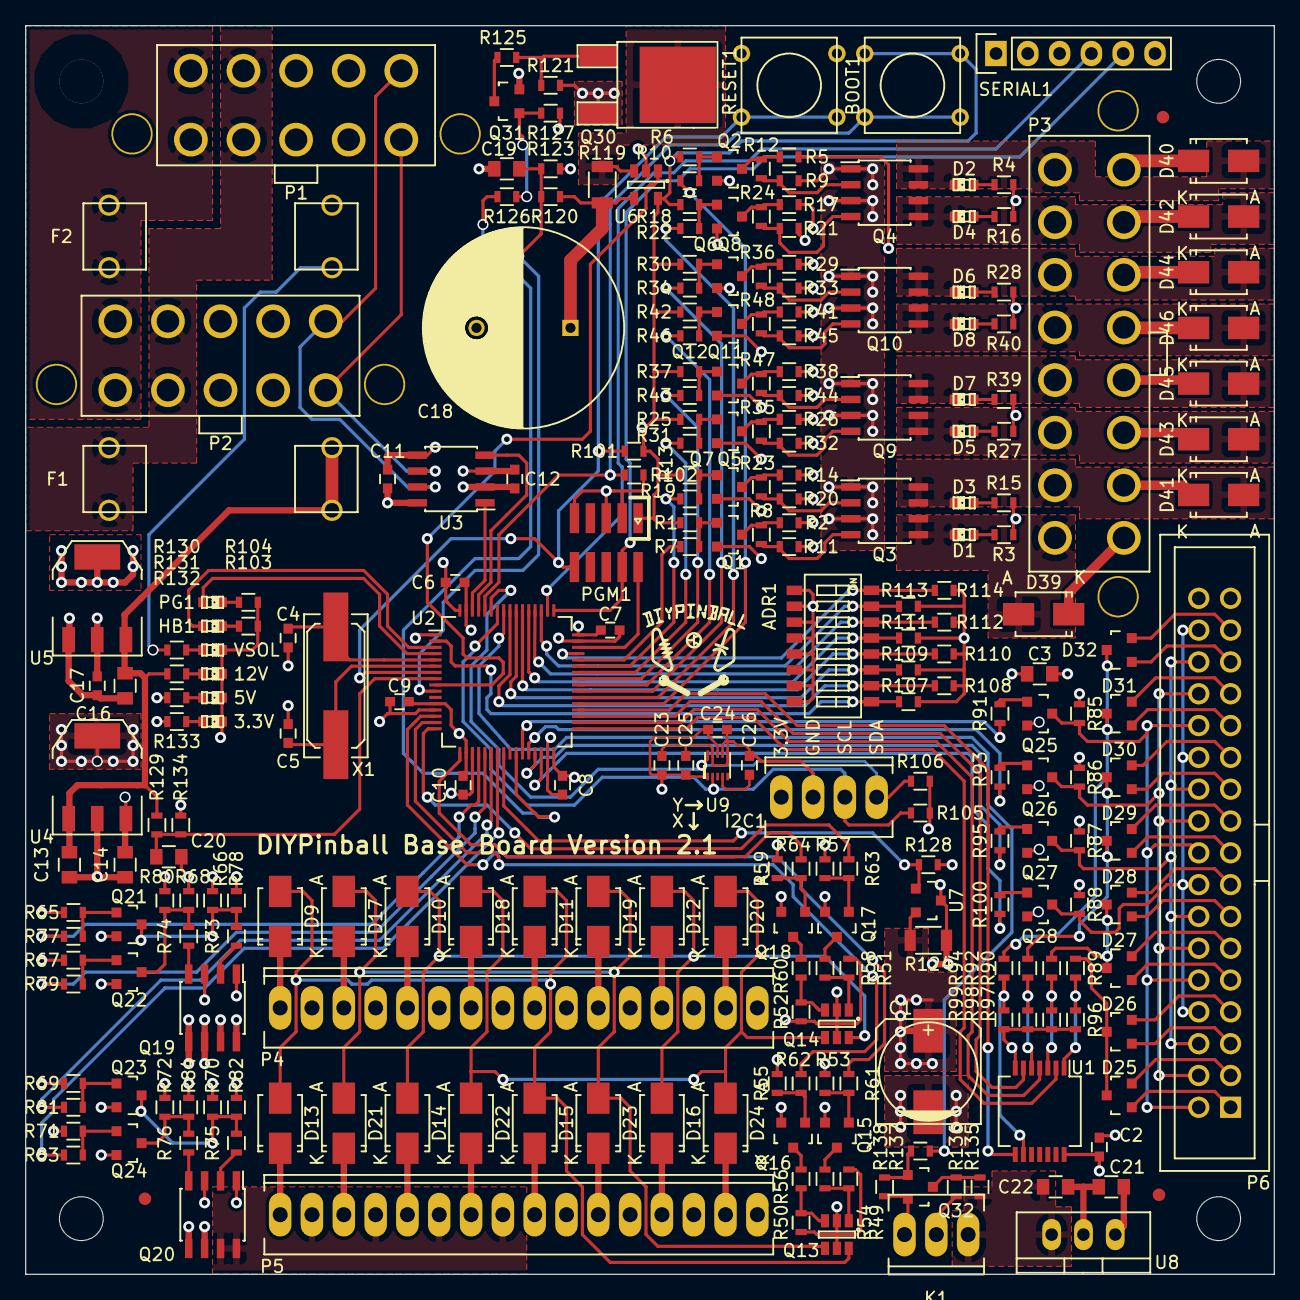
[picture p17: board base-module-hardware-v2.kicad_pcb from above]

Board: 4 copper layers, 99.7 x 99.7 mm, 263 parts (0 on the bottom side), 197 nets.

Other parts of the board:
FIDUCIAL: VAL**; FIDUCIAL
FIDUCIAL#2, FIDUCIAL#3: VAL**; FIDUCIAL
