diypinball/base-module-pcb/(commit log)

2013-04-09 Adding structure of new schematic project
    [base-module.sch, lamp-matrix.sch, power-supply.sch, solenoid-driver.sch, switch-matrix.sch]
2013-04-09 Adding hierarchy of schematics to project
    [base-module.sch, lamp-matrix.sch, power-supply.sch, solenoid-driver.sch, switch-matrix.sch]
2013-04-10 Started work on switch matrix.
    [base-module.sch, lamp-matrix.sch, power-supply.sch, solenoid-driver.sch, switch-matrix.sch]
2013-04-10 Added library for custom parts Switch matrix and solenoid driver mostly done
    [base-module.sch, lamp-matrix.sch, power-supply.sch, solenoid-driver.sch, switch-matrix.sch]
2013-04-10 Updating switch matrix to use pullups on row inputs rather than pulldowns, so that it will actually work
    [base-module.sch, lamp-matrix.sch, power-supply.sch, solenoid-driver.sch, switch-matrix.sch]
2013-04-13 Fixed switch matrix to match Mike's sketches Added lamp matrix
    [base-module.sch, lamp-matrix.sch, power-supply.sch, solenoid-driver.sch, switch-matrix.sch]
2013-04-14 Added the mcu and testing the git commit
    [LPC11C24.sch, base-module.sch, lamp-matrix.sch, power-supply.sch, solenoid-driver.sch, switch-matrix.sch]
2013-04-14 Changed the controller symbol for the LPC11C24 added some of the support components,played with the larger blocks
    [LPC11C24.sch, base-module.sch, lamp-matrix.sch, power-supply.sch, solenoid-driver.sch, standard_connector.sch, switch-matrix.sch]
2013-04-14 changed the voltage lbaels to global labels
    [LPC11C24.sch, base-module.sch, lamp-matrix.sch, power-supply.sch, solenoid-driver.sch, standard_connector.sch, switch-matrix.sch]
2013-04-15 did the power sheet
    [LPC11C24.sch, base-module.sch, lamp-matrix.sch, power-supply.sch, solenoid-driver.sch, standard_connector.sch, switch-matrix.sch]
2013-04-15 updated the power circut to include the more hidden preferences on the data sheet
    [LPC11C24.sch, base-module.sch, lamp-matrix.sch, power-supply.sch, solenoid-driver.sch, standard_connector.sch, switch-matrix.sch]
2013-04-15 added some stuff to the main controller schematic
    [LPC11C24.sch, base-module.sch, lamp-matrix.sch, power-supply.sch, solenoid-driver.sch, standard_connector.sch, switch-matrix.sch]
2013-04-16 power updated still need to add underpad also changed input connector to 5 pin and added fuses, added current sense with op-amp for solinoids
    [CurrentSense.sch, LPC11C24.sch, base-module.sch, lamp-matrix.sch, power-supply.sch, solenoid-driver.sch, standard_connector.sch, switch-matrix.sch]
2013-04-16 added the other two current sense outputs and modified the power circut, i cant seem to add the 9th pad, the bottom thermal pad????
    [3V3CurrentSense.sch, CurrentSense.sch, LPC11C24.sch, base-module.sch, lamp-matrix.sch, power-supply.sch, solenoid-driver.sch, standard_connector.sch]
2013-04-17 added dip switch library and modifed current sense's to add capsstarted the main controller page
    [3V3CurrentSense.sch, CurrentSense.sch, LPC11C24.sch, base-module.sch, lamp-matrix.sch, power-supply.sch, solenoid-driver.sch, standard_connector.sch]
2013-04-17 changed the controller adding some shift registers
    [3V3CurrentSense.sch, CurrentSense.sch, LPC11C24.sch, base-module.sch, lamp-matrix.sch, power-supply.sch, solenoid-driver.sch, standard_connector.sch]
2013-04-18 finished main controller, added LED's to power system.
    [3V3CurrentSense.sch, CurrentSense.sch, LPC11C24.sch, base-module.sch, lamp-matrix.sch, power-supply.sch, solenoid-driver.sch, standard_connector.sch]
2013-04-18 ran an ERC and touched up a couple small issues
    [3V3CurrentSense_2.sch, CurrentSense.sch, LPC11C24.sch, base-module.sch, lamp-matrix.sch, power-supply.sch, solenoid-driver.sch, standard_connector.sch]
2013-04-19 added some more info to the different components, changed the pinout for zeeners, and am hating ki-cad for schematic to pads.
    [3V3CurrentSense_2.sch, CurrentSense.sch, LPC11C24.sch, base-module.sch, lamp-matrix.sch, power-supply.sch, solenoid-driver.sch, standard_connector.sch]
2013-04-27 added more footprints, connectors and inductors are currently wronggit add .git add . must be changed
    [3V3CurrentSense.sch, 3V3CurrentSense_2.sch, CurrentSense.sch, LPC11C24.sch, base-module.kicad_pcb, base-module.sch, lamp-matrix.sch, power-supply.sch]
2013-04-29 Adding EAGLE version of schematic. Needs some cleaning, almost done.
    [pinball-general-r1.sch]
2013-04-30 Finished schematic, and renamed. Added start of board file, with some layout done.
    [base-module-r1.brd, base-module-r1.sch, pinball-general-r1.sch]
2013-04-30 Switched solenoid connectors to 2 2x4 instead of 4 2x2
    [base-module-r1.brd, base-module-r1.sch]
2013-05-02 More routing work
    [base-module-r1.brd]
2013-05-07 added another file with suffex MI for some testing of other layout methods
    [base-module-r1_MI_1.brd, base-module-r1_MI_1.sch]
2013-05-09 wtf is happening
    [base-module-r1_MI_1.brd]
2013-05-10 More layout work. Changed connections to lamp matrix to make the layout easier. Started adding planes. Trying to go for a ground-only fill on the bottom layer.
    [base-module-r1.brd, base-module-r1.sch, base-module-r1_MI_1.sch]
2013-05-11 More layout work done. So far the board is fitting in 10cm x 15cm, but MUCH more routing is to be done.
    [base-module-r1.brd, base-module-r1.sch]
2013-05-12 All parts placed, everything but power and CAN looks to be routed. Hoping someone can pick up where I left off - I'm done for now.
    [base-module-r1.brd, base-module-r1.sch]
2013-05-13 changed via locations to reduce drc errors, and routed CAN lines
    [base-module-r1.brd]
2013-05-14 no more ratsnets and good drc
    [base-module-r1.brd]
2013-05-15 added full ground plane over top layer, changed silkscreen
    [base-module-r1.brd, base-module-r1.sch]
2013-05-17 Cleaned up silkscreen and made ground plane continuous. Then cut out ground plane around middle digital section somewhat to keep switching noise from transistors from interfering with microcontroller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
    [base-module-r1.brd, base-module-r1.sch]
2013-05-17 Removing old KiCAD stuff
    [3V3CurrentSense.sch, 3V3CurrentSense_2.sch, CurrentSense.sch, LPC11C24.sch, base-module.kicad_pcb, base-module.sch, lamp-matrix.sch, power-supply.sch]
2013-05-20 Added some capacitance to the supply rails, 12V and 50V. Might be a good idea, what with all the instantaneous current draw and what not.
    [base-module-r1.brd, base-module-r1.sch]
2013-05-20 Added some more part numbers. All we need to do at this point is verify the shunt resistors for the current sensing, and I think we're good to go.
    [base-module-r1.brd, base-module-r1.sch]
2013-05-29 Adding Gerbers and logos to board. Removing MI version of board, as we're not using it. BOARDS ORDERED.
    [base-module-r1.GBL, base-module-r1.GBO, base-module-r1.GBP, base-module-r1.GBS, base-module-r1.GTL, base-module-r1.GTO, base-module-r1.GTP, base-module-r1.GTS]
2013-06-02 modified resistor values, changd the n-fet for the lamps to bo inline with the solinoid controller.
    [Resistor Calculations Workbook.xlsx, base-module-r1.brd, base-module-r1.sch]
2013-09-16 Adding version 1.1 of the hardware, fixing a few bugs
    [base-module-r1.1.brd, base-module-r1.1.sch, base-module-r1.brd, base-module-r1.sch]
2014-03-17 Adding start of version 2.0 hardware, using KiCAD
    [base-module-hardware-v2.sch, control-logic.sch, lamp-driver.sch, power-supply.sch, solenoid-driver.sch, switch-matrix.sch]
2014-03-17 Added RGB output and finished power supply monitor schematic, including new current monitor and voltage monitor divider values.
    [base-module-hardware-v2.sch, control-logic.sch, lamp-driver.sch, power-supply.sch, rgb-led-output.sch, solenoid-driver.sch, switch-matrix.sch]
2014-04-02 Adding I2C connector and reannotating to reflect that
    [base-module-hardware-v2.sch, control-logic.sch, lamp-driver.sch, power-supply.sch, rgb-led-output.sch, solenoid-driver.sch, switch-matrix.sch]
2015-02-22 Cleaning up schematic Updating solenoid driver to use 12V for MOSFET gates instead of Vsol so we never exceed Vgs_max
    [base-module-hardware-v2.sch, control-logic.sch, lamp-driver.sch, power-supply.sch, rgb-led-output.sch, solenoid-driver.sch, switch-matrix.sch]
2015-06-01 Started layout on 2.0
    [accelerometer.sch, base-module-hardware-v2.csv, base-module-hardware-v2.kicad_pcb, base-module-hardware-v2.sch, control-logic.sch, lamp-driver.sch, power-supply.sch, rgb-led-output.sch]
2015-06-01 Tweaking layout to make power supply fit
    [base-module-hardware-v2.kicad_pcb]
2015-06-03 Everything fits on the board area now. Still need to finish wiring.
    [base-module-hardware-v2.kicad_pcb]
2015-06-04 2.0 is getting very close. Adjusted the solenoid connections to allow a cleaner layout.
    [base-module-hardware-v2.kicad_pcb, control-logic.sch]
2015-06-04 Power layers set up. A few footprint/pinout changes and some silkscreen cleanup, and the first rev is complete.
    [base-module-hardware-v2.kicad_pcb, control-logic.sch]
2015-06-04 100% routed.
    [base-module-hardware-v2.kicad_pcb, switch-matrix.sch]
2015-06-05 Finished layout! Needs review.
    [base-module-hardware-v2.kicad_pcb]
2015-06-07 Added OSHW logo
    [base-module-hardware-v2.kicad_pcb]
2015-06-15 Fixing BAT54C pinout, and some feedback from layout review.
    [base-module-hardware-v2.kicad_pcb, power-supply.sch, rgb-led-output.sch, switch-matrix.sch]
2015-06-15 Updated solenoid driver with new resistor arrangement, and changed footprint on switch matrix to a connector we can actually get.
    [base-module-hardware-v2.kicad_pcb, solenoid-driver.sch, switch-matrix.sch]
2015-06-26 Finishing layout updates from review with Mike.
    [base-module-hardware-v2.kicad_pcb, control-logic.sch, power-supply.sch]
2015-06-26 Logo placement adjustment
    [base-module-hardware-v2.kicad_pcb]
2015-06-26 Adding CAM data
    [base-module-hardware-v2.gbl, base-module-hardware-v2.gbo, base-module-hardware-v2.gbp, base-module-hardware-v2.gbs, base-module-hardware-v2.gtl, base-module-hardware-v2.gto, base-module-hardware-v2.gtp, base-module-hardware-v2.gts]
2015-06-28 Fixed labelling of axes on accelerometer.
    [base-module-hardware-v2.gbl, base-module-hardware-v2.gbo, base-module-hardware-v2.gbp, base-module-hardware-v2.gbs, base-module-hardware-v2.gtl, base-module-hardware-v2.gto, base-module-hardware-v2.gtp, base-module-hardware-v2.gts]
2015-10-16 Removing old version
    [Resistor Calculations Workbook.xlsx, base-module-r1.1.brd, base-module-r1.1.sch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]
2015-10-16 Committing latest files. This includes the KiCAD 4.0.0rc1 migration as well as the updates to Base Board 2.1.
    [accelerometer.sch, base-module-hardware-v2.kicad_pcb, base-module-hardware-v2.sch, control-logic.sch, lamp-driver.sch, power-supply.sch, rgb-led-output.sch, solenoid-driver.sch]
2015-10-16 Moving 2.x files to root
    [accelerometer.sch, base-module-hardware-v2.csv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]
2015-10-25 Fixing reversed 5V regulator and adding polarized header for WS2812B strip output.
    [base-module-hardware-v2.kicad_pcb, rgb-led-output.sch]
2016-09-09 Latest changes (so old I don't remember)
    [accelerometer.sch, base-module-hardware-v2.kicad_pcb, control-logic.sch, power-supply.sch, rgb-led-output.sch, switch-matrix.sch]
